ErwinRafaelNovicio/4dof-robot-manipulator/code/ellipses/force_frame/ConditioningNumber2.jpg

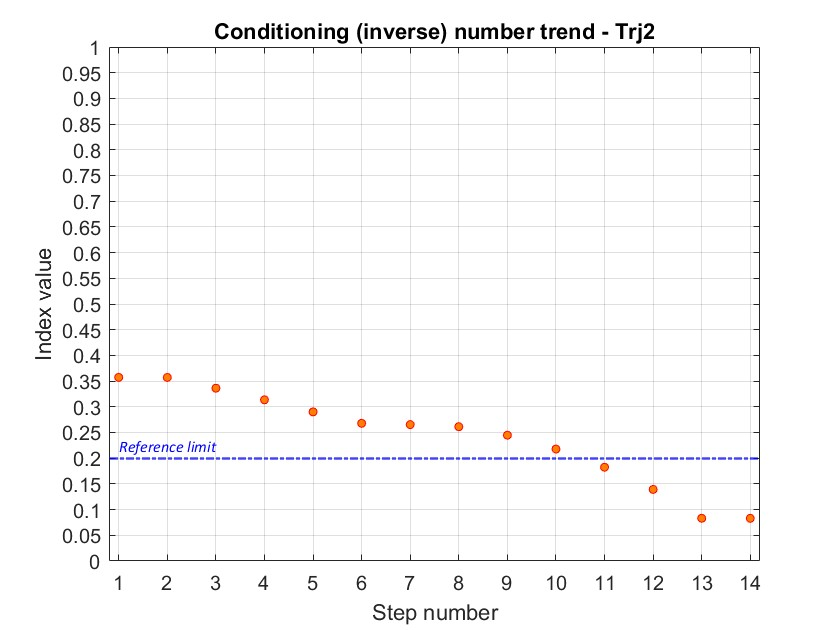
code/ellipses/force_frame/ConditioningNumber2.jpg
