ErwinRafaelNovicio/4dof-robot-manipulator/code/ellipses/velocity_frame/ConditioningNumber2.jpg

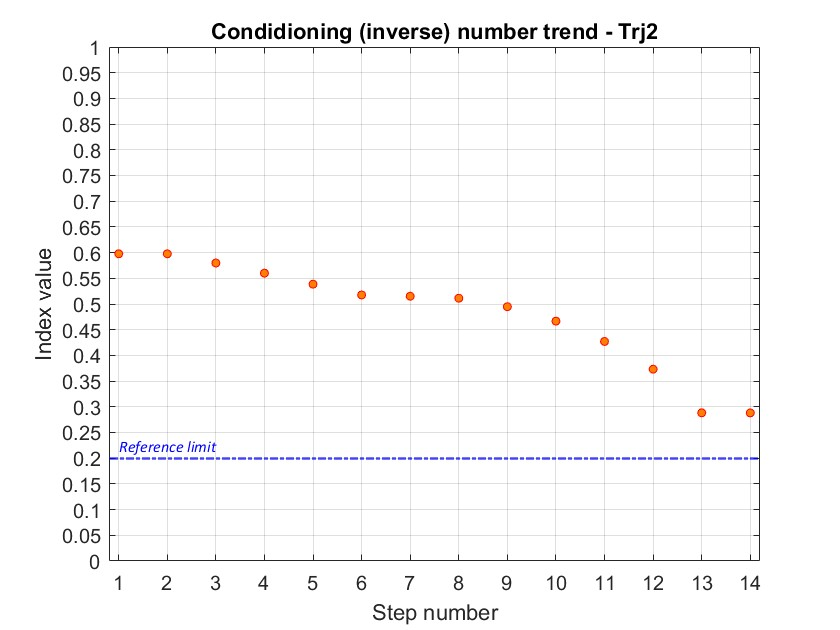
code/ellipses/velocity_frame/ConditioningNumber2.jpg
