ErwinRafaelNovicio/4dof-robot-manipulator/code/ellipses/velocity_frame/trajectory1/frame_1_0004.png

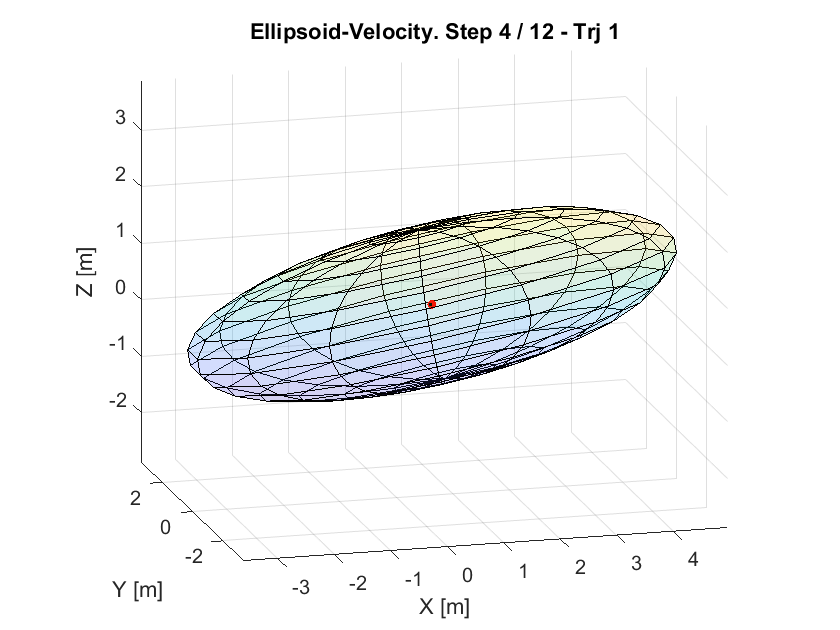
code/ellipses/velocity_frame/trajectory1/frame_1_0004.png
