ErwinRafaelNovicio/4dof-robot-manipulator/code/ellipses/velocity_frame/trajectory1/frame_1_0005.png

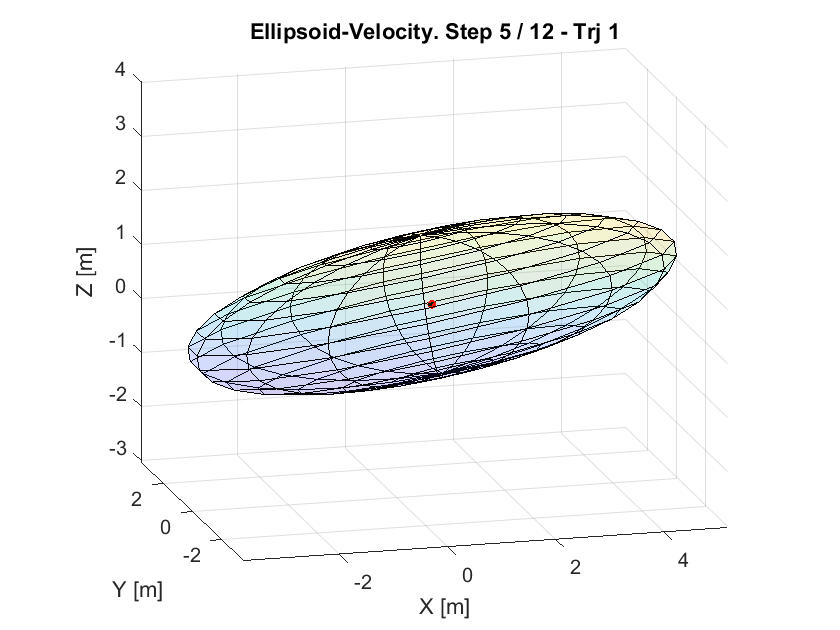
code/ellipses/velocity_frame/trajectory1/frame_1_0005.png
