ErwinRafaelNovicio/4dof-robot-manipulator/code/ellipses/velocity_frame/trajectory2/frame_2_0012.png

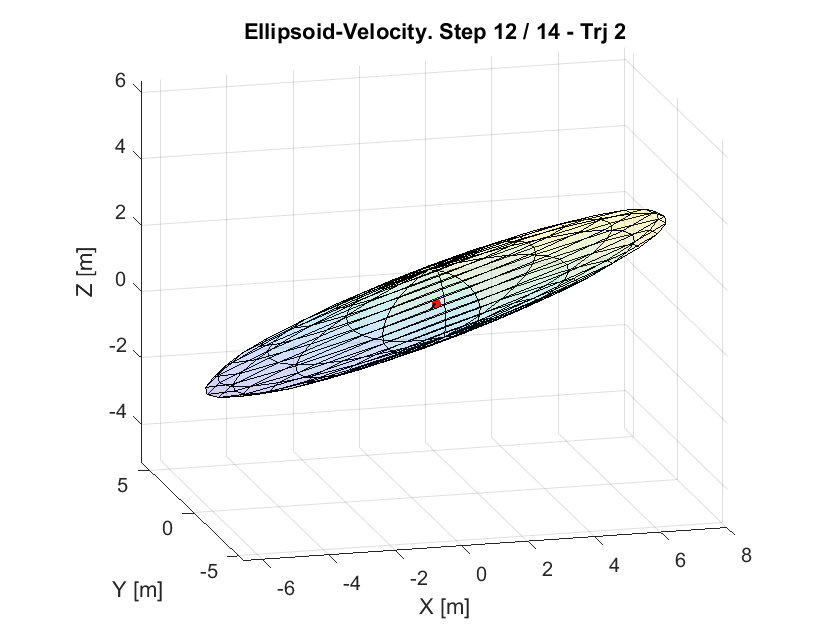
code/ellipses/velocity_frame/trajectory2/frame_2_0012.png
