ErwinRafaelNovicio/4dof-robot-manipulator/cad/helmet/Helmet.STEP

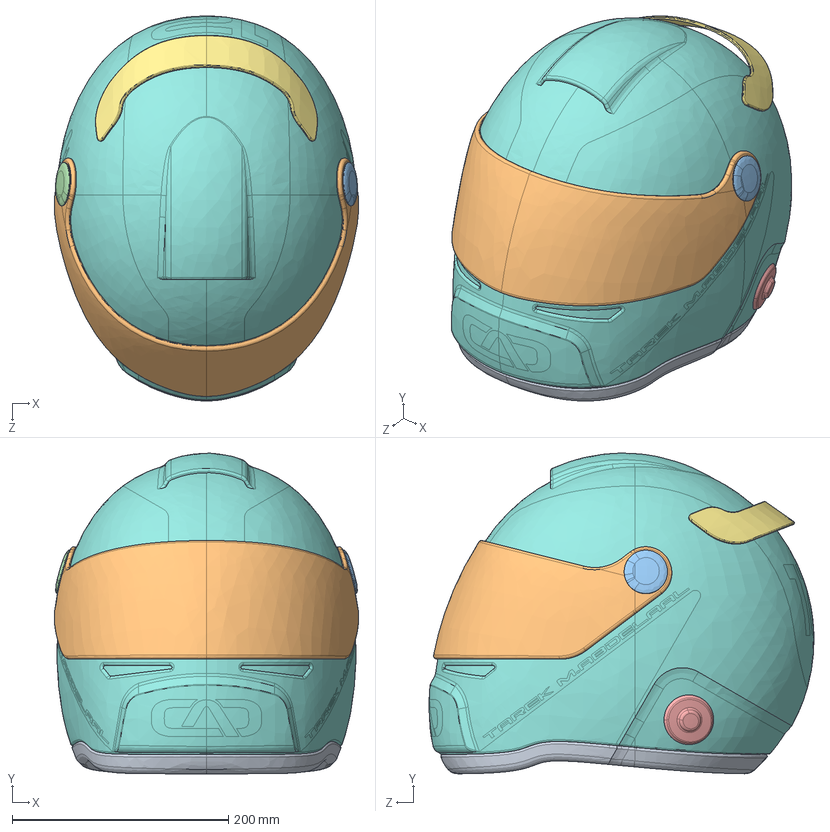
[picture p97: CAD file, 2026-11-09]
cad/helmet/Helmet.STEP
281.6 x 296.7 x 356.3 mm
