ErwinRafaelNovicio/4dof-robot-manipulator/(list of files, cad)

Other CAD files:
cad/3d_model/1.1_1_SideArm.ipt
cad/3d_model/1.1_2_SideArmClose.ipt
cad/3d_model/1.1_3_Shaft_A.ipt
cad/3d_model/1.1_4_Shaft_B.ipt
cad/3d_model/1.1_5_Base.ipt
cad/3d_model/1.1_6_SpacerA.ipt
cad/3d_model/1.1_7_SpacerB.ipt
cad/3d_model/1.1_FixedArm.iam
cad/3d_model/1.2_1_SideArm.ipt
cad/3d_model/1.2_2_SideArmClose.ipt
cad/3d_model/1.2_3_Shaft_A.ipt
cad/3d_model/1.2_4_SpacerA.ipt
cad/3d_model/1.2_5_SpacerB.ipt
cad/3d_model/1.2_CobotArm.iam
cad/3d_model/1.3_1_SideArm.ipt
cad/3d_model/1.3_2_SideArmClose.ipt
cad/3d_model/1.3_3_Shaft_A.ipt
cad/3d_model/1.3_CobotArm.iam
cad/3d_model/1.4_1_EndEffector.ipt
cad/3d_model/1.4_1_EndEffector_OLD.ipt
cad/3d_model/1.4_2_EndEffector.ipt
cad/3d_model/1.4_EndEffector.iam
cad/3d_model/1.5_1_MainBase.ipt
cad/3d_model/1.5_2_MainBaseCover.ipt
cad/3d_model/1.5_3_SpacerA.ipt
cad/3d_model/1.5_4_SpacerB.ipt
cad/3d_model/1.5_Base.iam
cad/3d_model/BEARING_6007-2Z.ipt
cad/3d_model/BEARING_61816-2RZ.ipt
cad/3d_model/BEARING_61816-2RZ_MIR.ipt
cad/3d_model/BEARING_61903-2RZ.ipt
cad/3d_model/BEARING_6204-2Z.ipt
cad/3d_model/BEARING_628-2Z.ipt
cad/3d_model/BEARING_7310_BE-2RZP_2.ipt
cad/3d_model/HG-MR13B-D.ipt
cad/3d_model/HG-MR23B-K.ipt
cad/3d_model/M6 Unheaded Heat-Sert Insert for Plastic.ipt
cad/3d_model/M8 Unheaded Heat-Sert Insert for Plastic.ipt
cad/3d_model/Manipulator_4DOFs.iam
cad/3d_model/Timing_Pulley_22002-051015.ipt
cad/3d_model/Timing_Pulley_22002-051020.ipt
cad/3d_model/Timing_Pulley_22002-051020_V1.ipt
cad/3d_model/Timing_Pulley_22002-051020_V2.ipt
cad/3d_model/Timing_Pulley_22002-051060.ipt
cad/3d_model/Timing_Pulley_22002-051060_V1.ipt
cad/3d_model/Timing_Pulley_22002-051060_V2.ipt
cad/3d_model/Timing_Pulley_22002-051060_V3.ipt
cad/3d_model/Timing_Pulley_22002-101620.ipt
cad/3d_model/Timing_Pulley_22002-101640.ipt
cad/3d_model/TiminigBelt_A.ipt
cad/3d_model/TiminigBelt_B.ipt
cad/3d_model/TiminigBelt_C.ipt
cad/3d_model/TiminigBelt_D.ipt
cad/3d_model/TiminigBelt_E.ipt
cad/3d_model/TiminigBelt_F.ipt
cad/3d_model/TiminigBelt_G.ipt
cad/technical_drawings/assembly/Manipulator_4DOFs.idw
cad/technical_drawings/exploded/Cobot_Exploded.idw
cad/technical_drawings/parts/1.1_1_SideArm.idw
cad/technical_drawings/parts/1.2_1_SideArm.idw
cad/technical_drawings/parts/1.2_3_Shaft_A.idw
cad/technical_drawings/parts/1.3_1_SideArm.idw
cad/technical_drawings/parts/1.3_2_SideArmClose.idw
cad/technical_drawings/parts/1.4_1_EndEffector.idw
cad/technical_drawings/parts/1.5_1_MainBase.idw
cad/technical_drawings/parts/1.5_2_MainBaseCover.idw
