ErwinRafaelNovicio/4dof-robot-manipulator/(commit log)

2026-11-09 Add files via upload
    Kinematics codes
2026-11-09 Add files via upload
    Motor Identification codes
